alaaalim/EEG-Acquisition-and-Visualization-System/Test Pictures/WhatsApp Image 2025-12-20 at 18.33.53_05dec455.jpg

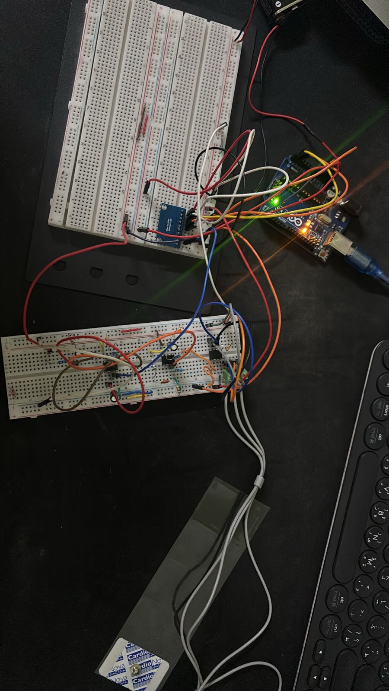
Test Pictures/WhatsApp Image 2025-12-20 at 18.33.53_05dec455.jpg
