alaaalim/EEG-Acquisition-and-Visualization-System/Test Pictures/WhatsApp Image 2025-12-18 at 02.12.41_78835ccd.jpg

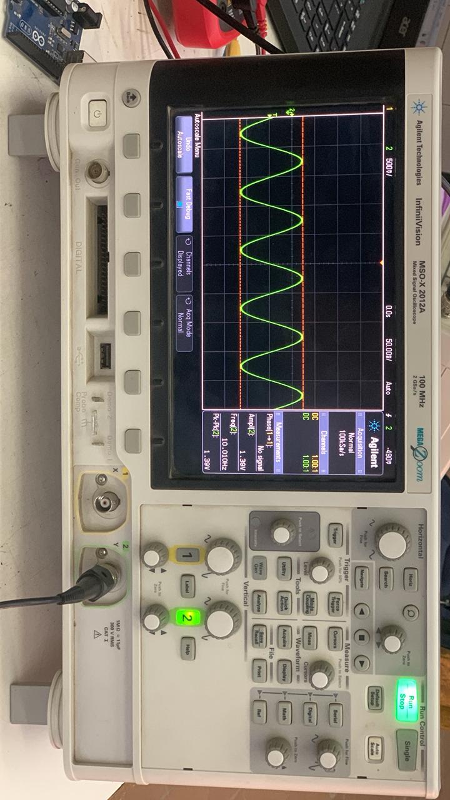
Test Pictures/WhatsApp Image 2025-12-18 at 02.12.41_78835ccd.jpg
