alaaalim/EEG-Acquisition-and-Visualization-System/Proteus_Circuit/EEG_Circuit/Circuit_Design.PNG

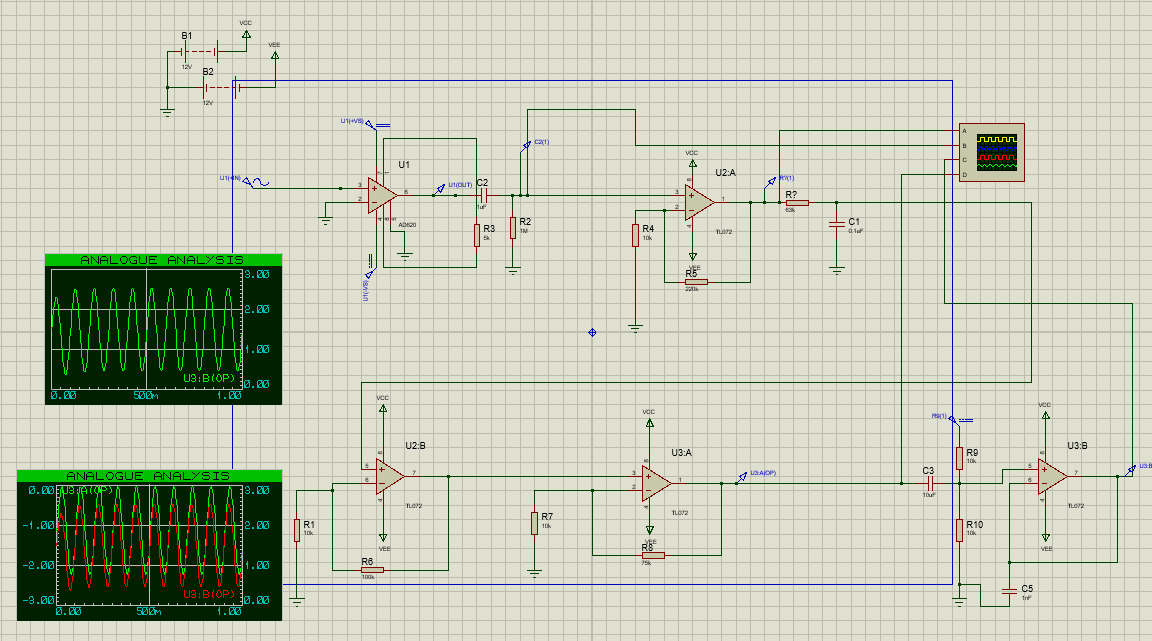
Proteus_Circuit/EEG_Circuit/Circuit_Design.PNG
