alaaalim/EEG-Acquisition-and-Visualization-System/Proteus_Circuit/EEG_Circuit/Simulation.PNG

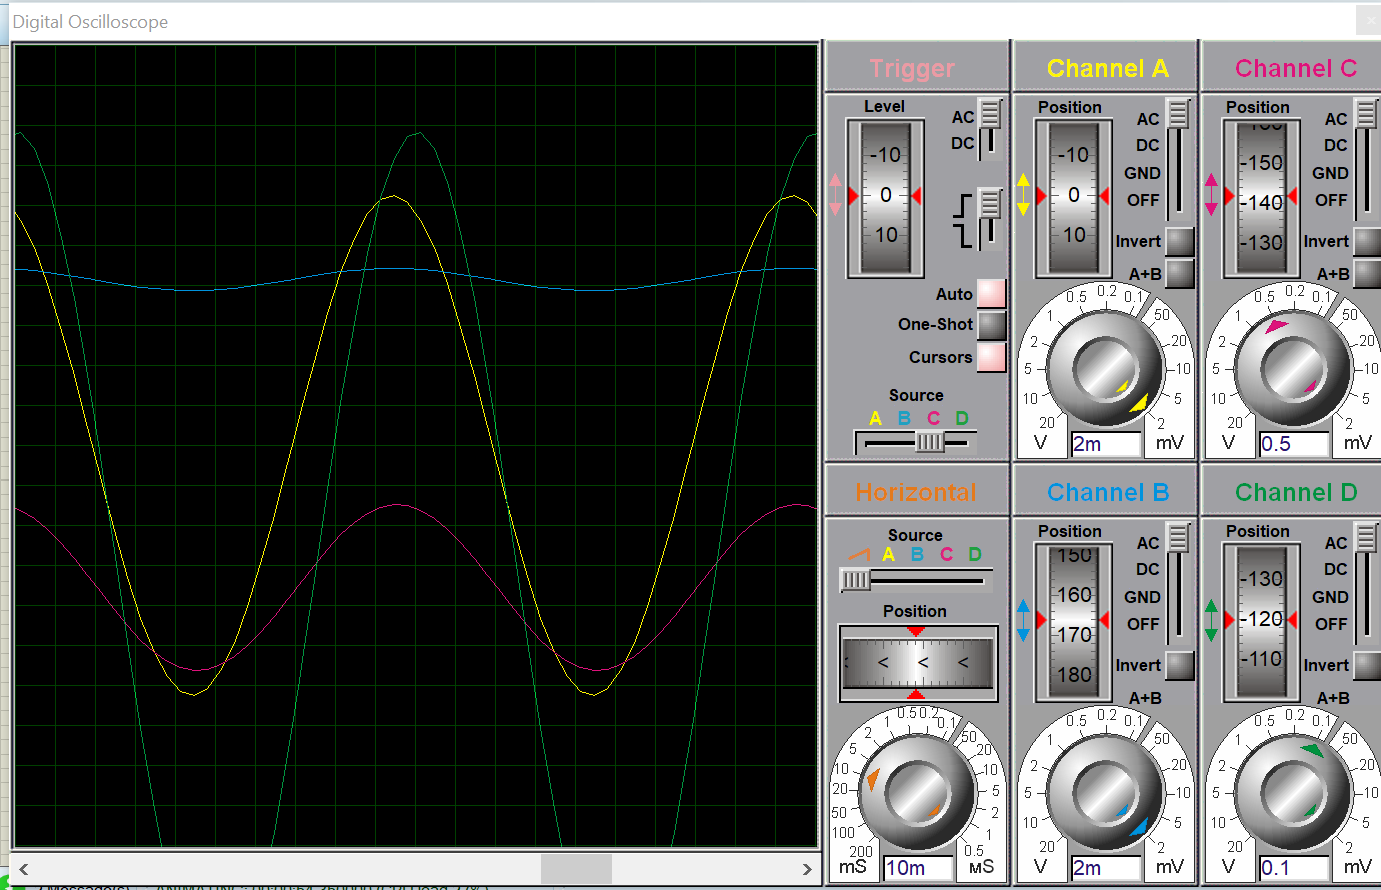
Proteus_Circuit/EEG_Circuit/Simulation.PNG
