alaaalim/EEG-Acquisition-and-Visualization-System/(list of files, drawings)

Other design files:
Proteus_Circuit/EEG.pdsprj
