alaaalim/EEG-Acquisition-and-Visualization-System/Test Pictures/CUI-1.jpg

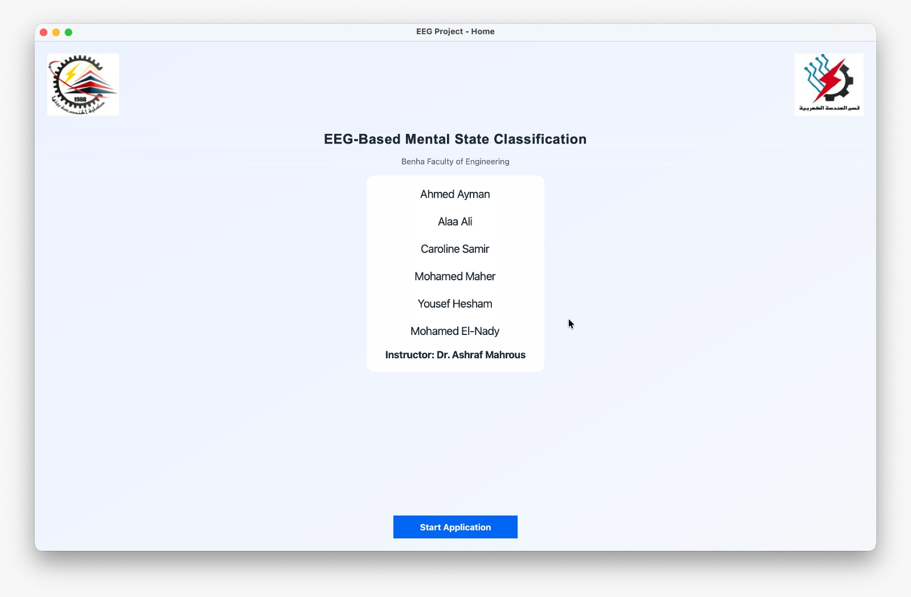
Test Pictures/CUI-1.jpg
