alaaalim/EEG-Acquisition-and-Visualization-System/Test Pictures/image.png

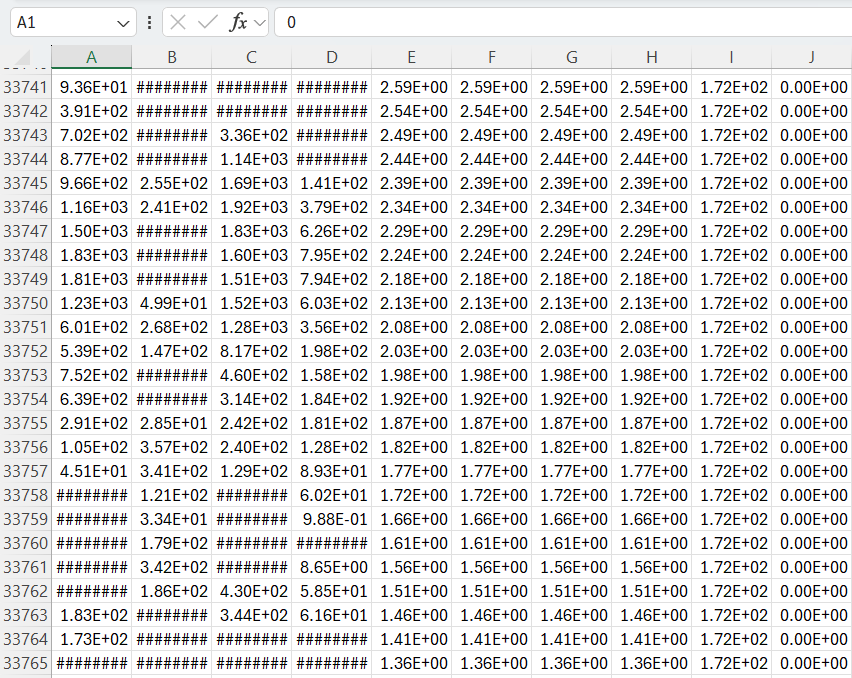
Test Pictures/image.png
