alaaalim/EEG-Acquisition-and-Visualization-System/Test Pictures/WhatsApp Image 2025-12-18 at 02.12.41_e20e552f.jpg

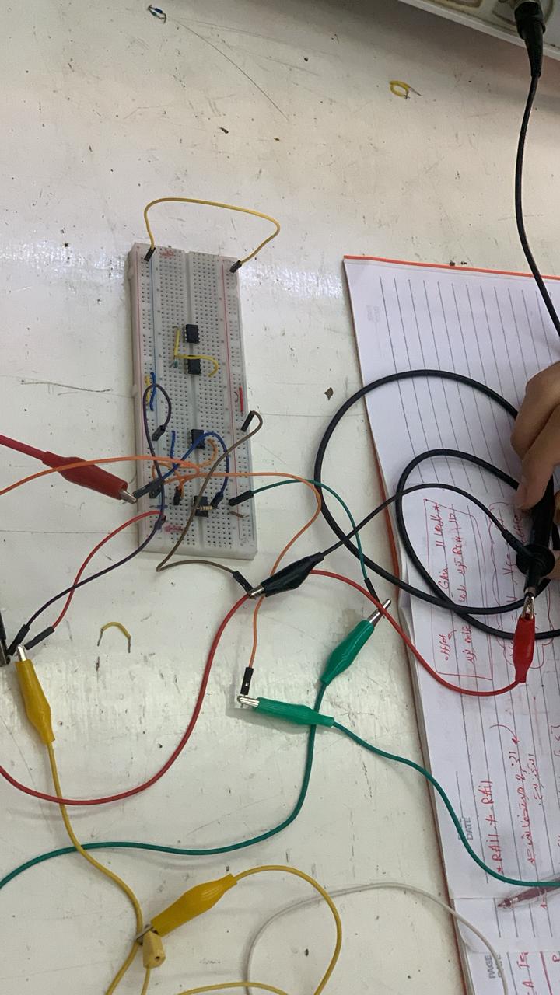
Test Pictures/WhatsApp Image 2025-12-18 at 02.12.41_e20e552f.jpg
