alaaalim/EEG-Acquisition-and-Visualization-System/Test Pictures/WhatsApp Image 2025-12-19 at 05.32.54_1de8c1d5.jpg

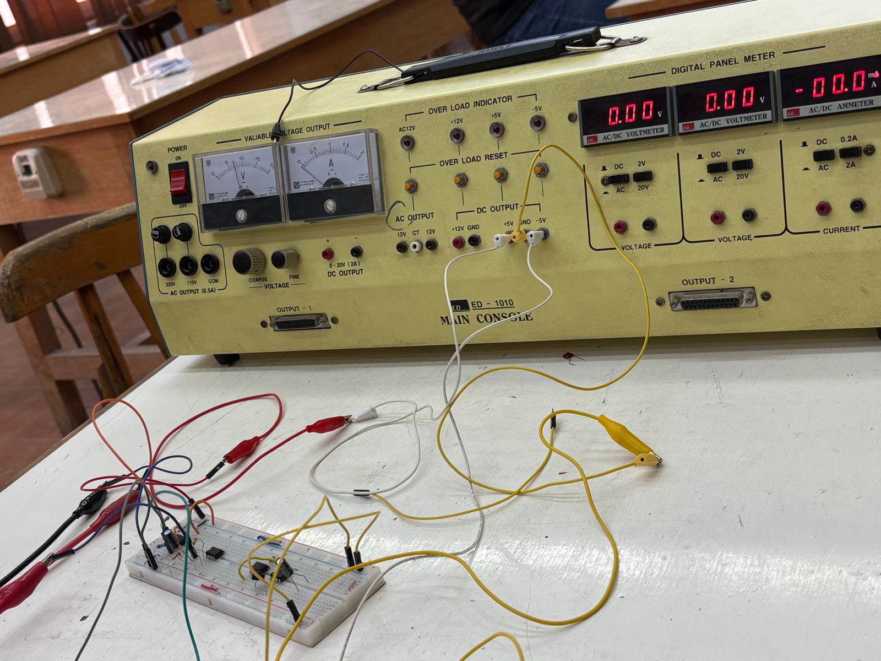
Test Pictures/WhatsApp Image 2025-12-19 at 05.32.54_1de8c1d5.jpg
