alaaalim/EEG-Acquisition-and-Visualization-System/Test Pictures/WhatsApp Image 2025-12-19 at 05.32.54_16d15d3c.jpg

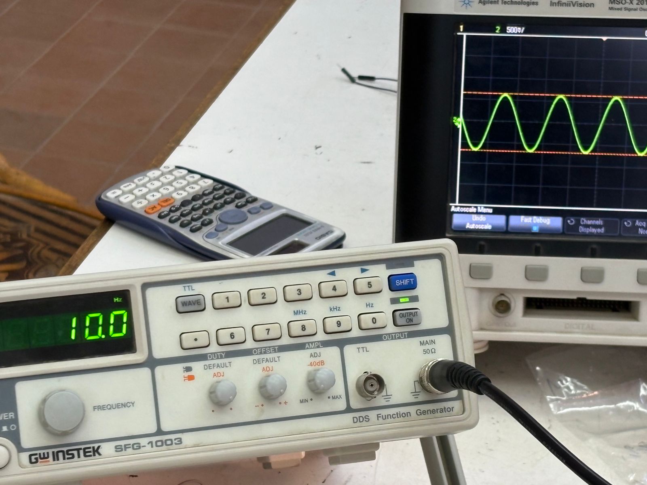
Test Pictures/WhatsApp Image 2025-12-19 at 05.32.54_16d15d3c.jpg
