alaaalim/EEG-Acquisition-and-Visualization-System/Test Pictures/WhatsApp Image 2025-12-19 at 05.32.55_558b6569.jpg

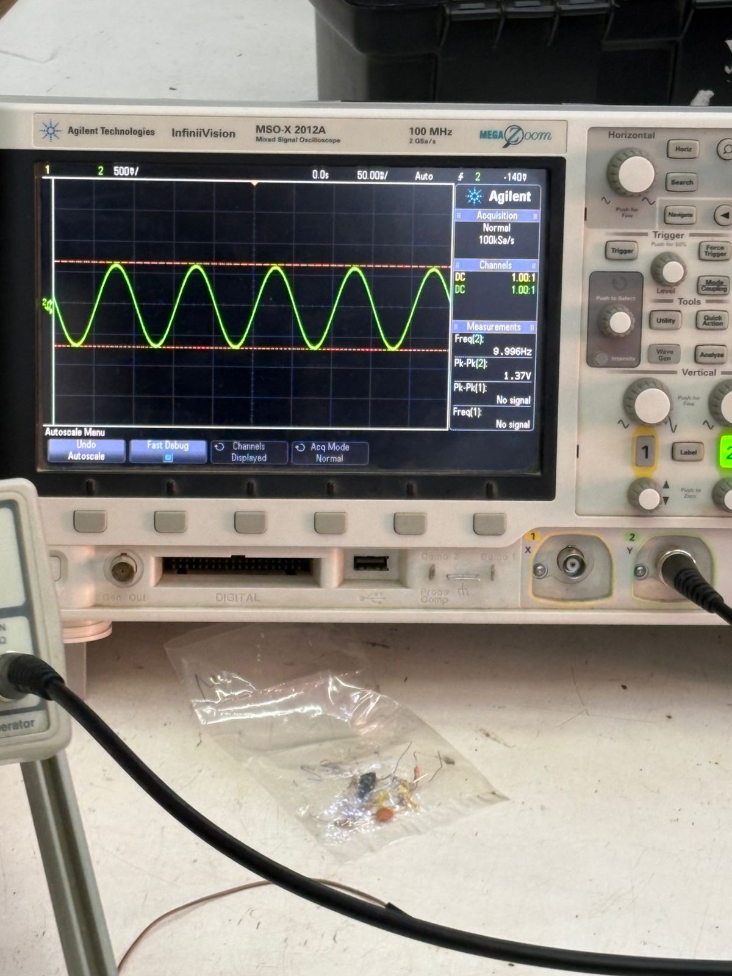
Test Pictures/WhatsApp Image 2025-12-19 at 05.32.55_558b6569.jpg
