alaaalim/EEG-Acquisition-and-Visualization-System/Test Pictures/WhatsApp Image 2025-12-20 at 18.33.30_c15d4ef0.jpg

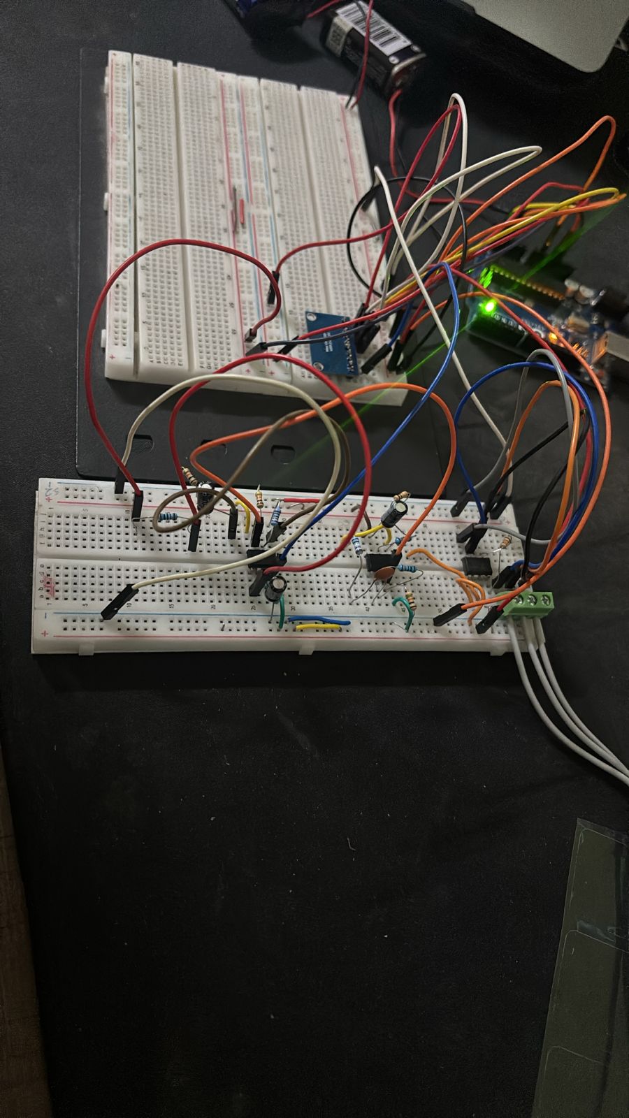
Test Pictures/WhatsApp Image 2025-12-20 at 18.33.30_c15d4ef0.jpg
