alaaalim/EEG-Acquisition-and-Visualization-System/Test Pictures/WhatsApp Image 2025-12-20 at 18.33.42_e437cb61.jpg

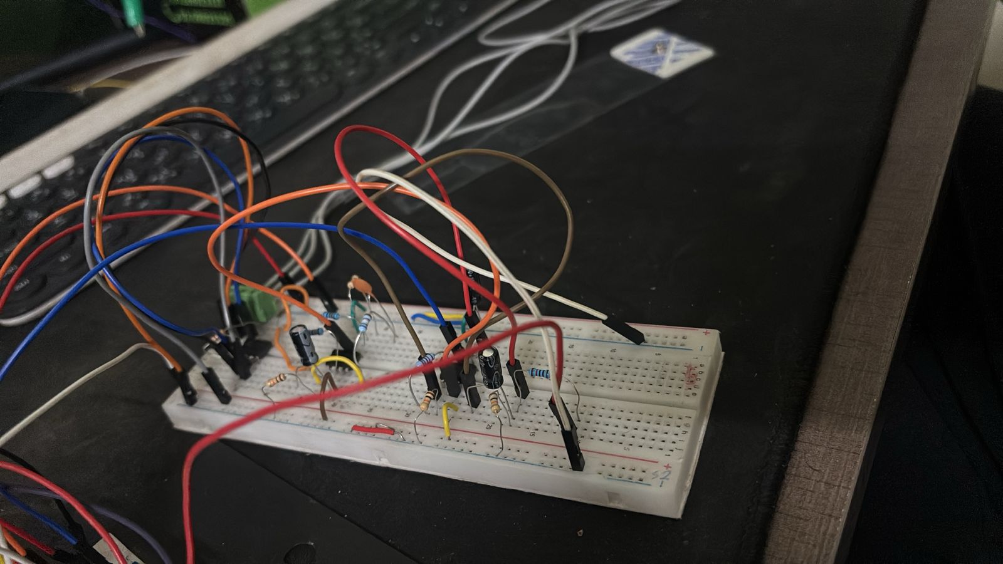
Test Pictures/WhatsApp Image 2025-12-20 at 18.33.42_e437cb61.jpg
